sshiraki/ss_hand/女性の手型3Dプリント設計図.png

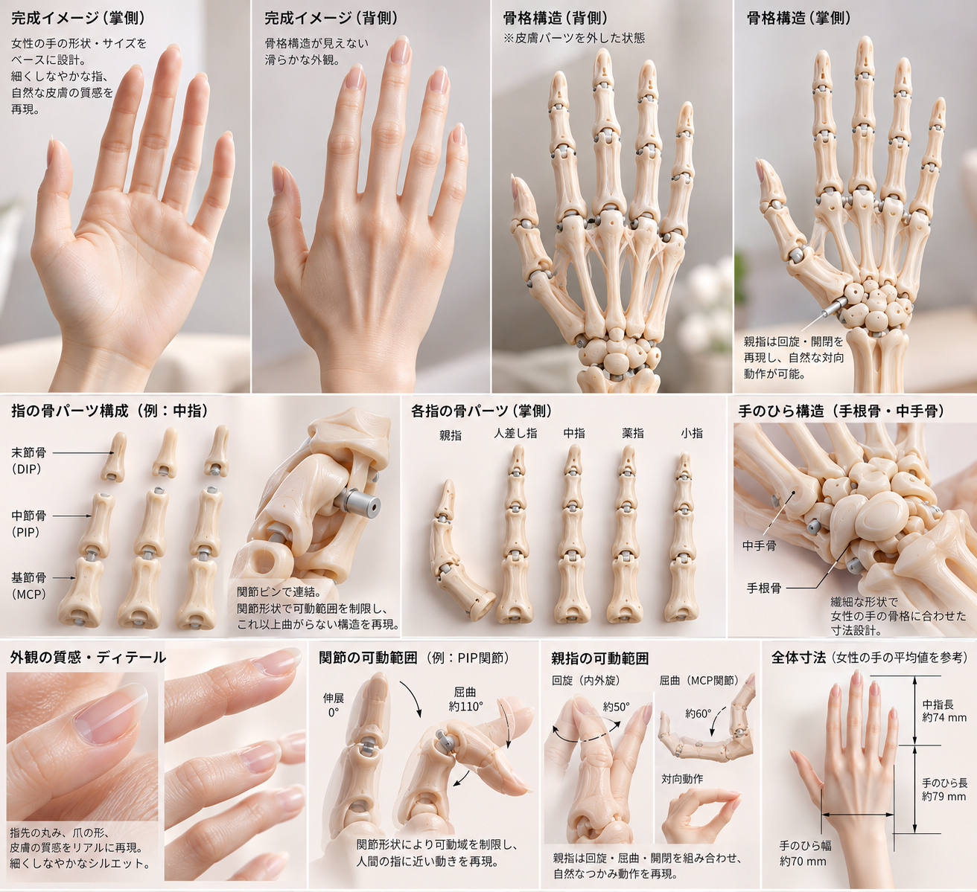
女性の手型3Dプリント設計図.png
