sshiraki/ss_hand/ball_joint_v11.png

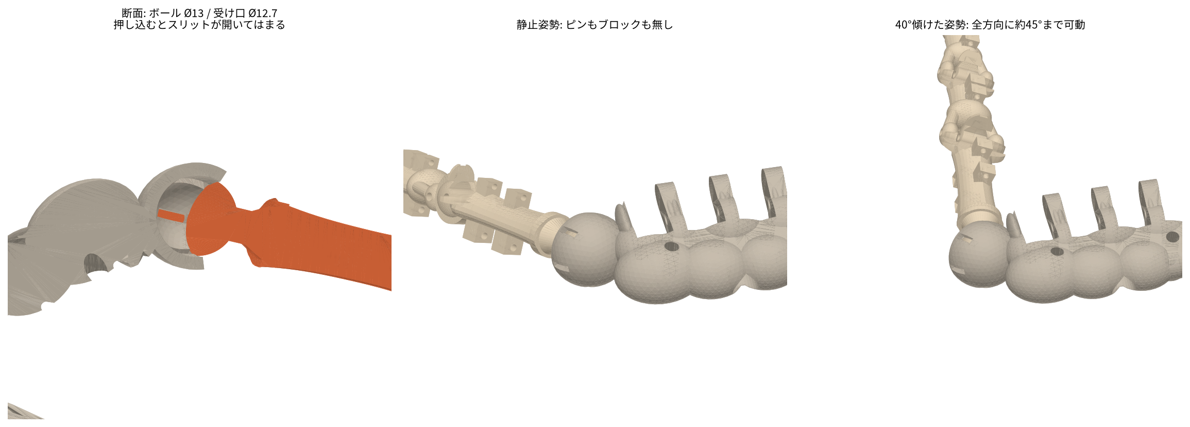
ball_joint_v11.png
