sshiraki/ss_hand/parts_list_v11.csv

part | vol_cm3 | size_x | size_y | size_z | watertight | components
carpus_wrist_base | 9.66 | 65.1 | 30.5 | 20.1 | True | 1
index_distal | 0.89 | 12.1 | 28.5 | 12.7 | True | 1
index_metacarpal | 3.08 | 14.7 | 73.2 | 14.0 | True | 1
index_middle | 1.19 | 13.3 | 34.8 | 13.7 | True | 1
index_proximal | 1.77 | 14.6 | 44.3 | 13.9 | True | 1
middle_distal | 1.0 | 12.7 | 30.0 | 13.1 | True | 1
middle_metacarpal | 3.47 | 15.3 | 75.6 | 14.5 | True | 1
middle_middle | 1.39 | 13.9 | 37.2 | 14.1 | True | 1
middle_proximal | 2.0 | 15.2 | 46.8 | 14.4 | True | 1
pinky_distal | 0.67 | 11.2 | 24.6 | 11.8 | True | 1
pinky_metacarpal | 2.3 | 12.8 | 64.3 | 13.2 | True | 1
pinky_middle | 0.81 | 11.9 | 28.8 | 12.9 | True | 1
pinky_proximal | 1.12 | 12.7 | 37.4 | 12.9 | True | 1
ring_distal | 0.89 | 12.1 | 28.5 | 12.7 | True | 1
ring_metacarpal | 2.99 | 14.7 | 71.2 | 14.0 | True | 1
ring_middle | 1.24 | 13.3 | 35.8 | 13.7 | True | 1
ring_proximal | 1.77 | 14.6 | 44.3 | 13.9 | True | 1
thumb_distal | 1.64 | 15.2 | 37.7 | 14.8 | True | 1
thumb_metacarpal | 4.04 | 17.2 | 61.5 | 16.8 | True | 1
thumb_proximal | 2.29 | 17.1 | 44.7 | 15.4 | True | 1
