sshiraki/ss_hand/3mf/assembly.3mf

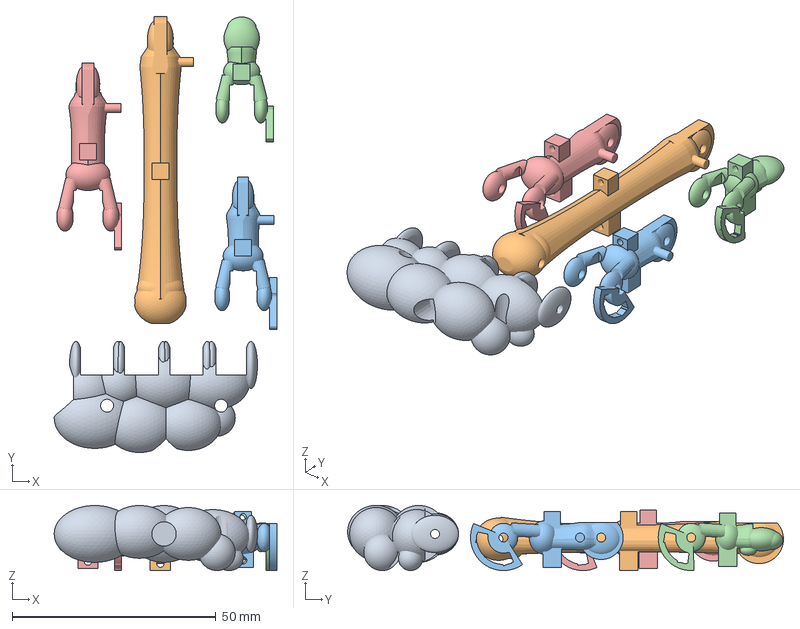
[picture p3: CAD file, 2026-11-10]
3mf/assembly.3mf
54.7 x 107.1 x 16.0 mm
carpus_wrist_base.stl
middle_metacarpal.stl
middle_middle.stl
middle_distal.stl
middle_proximal.stl
