sshiraki/ss_hand/3mf/middke.3mf

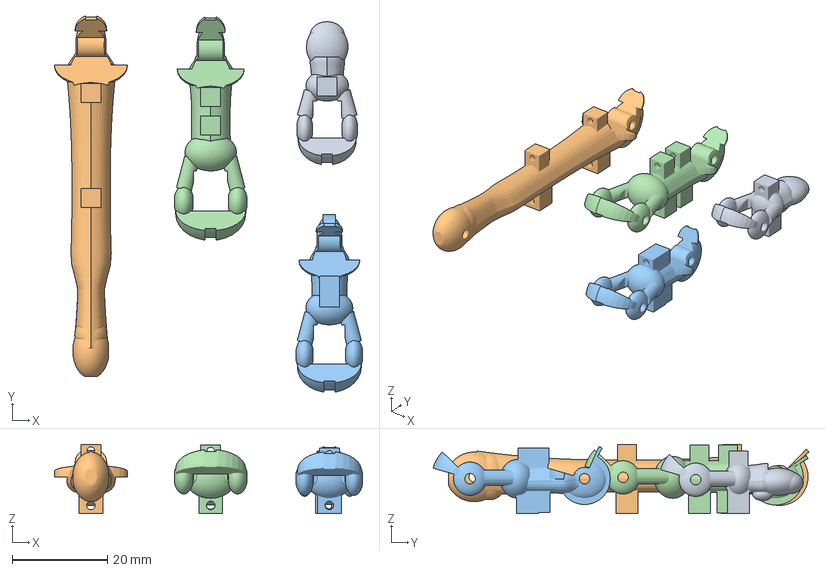
[picture p4: CAD file, 2026-11-10]
3mf/middke.3mf
64.6 x 78.8 x 14.5 mm
middle_distal.stl
middle_metacarpal.stl
middle_middle.stl
middle_proximal.stl
