sshiraki/ss_hand/stl/carpus_wrist_base.stl

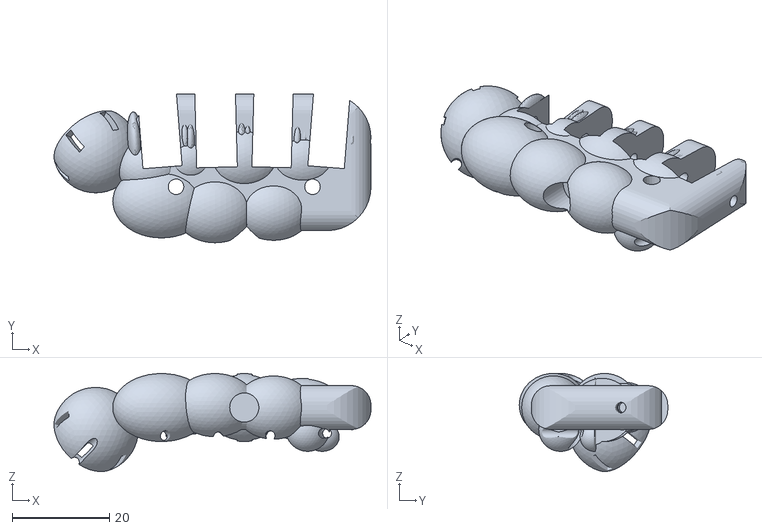
[picture p5: CAD file, 2026-11-10]
stl/carpus_wrist_base.stl
65.1 x 30.5 x 20.1
