sshiraki/ss_hand/3mf/thumb.3mf

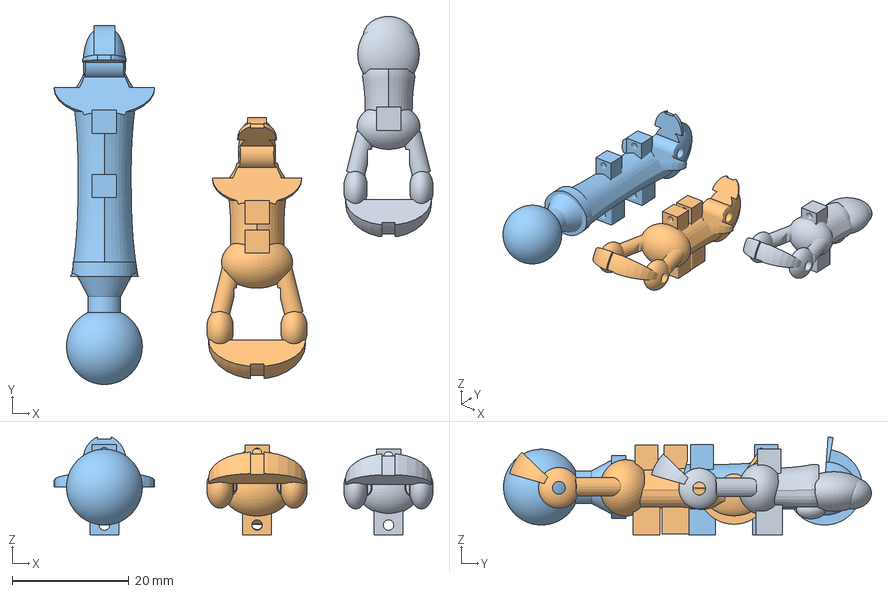
[picture p6: CAD file, 2026-11-10]
3mf/thumb.3mf
64.9 x 63.1 x 16.8 mm
thumb_distal.stl
thumb_proximal.stl
thumb_metacarpal.stl
