sshiraki/ss_hand/stl/thumb_metacarpal.stl

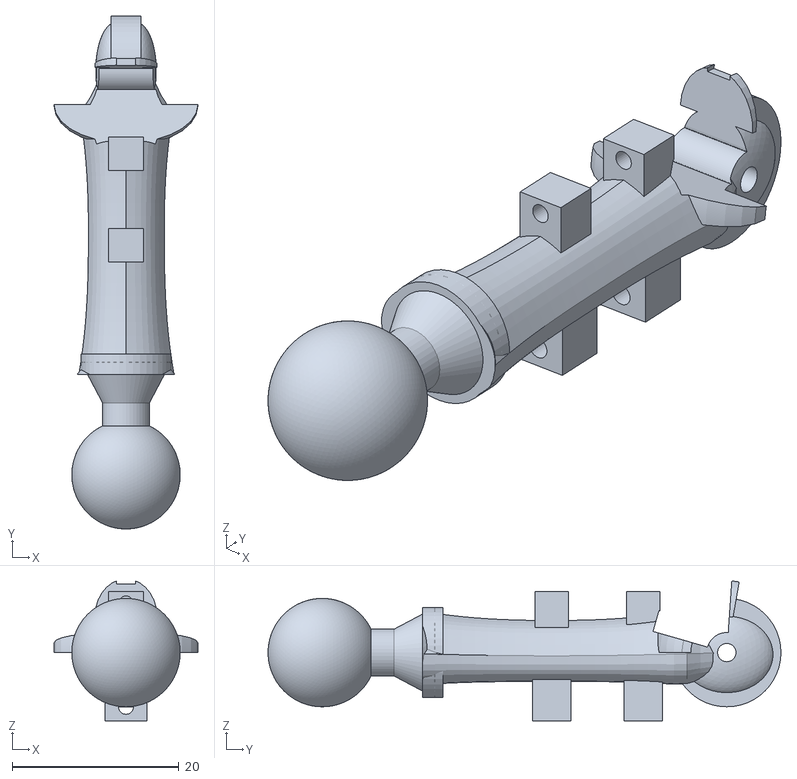
[picture p7: CAD file, 2026-11-10]
stl/thumb_metacarpal.stl
17.2 x 61.5 x 16.8
