sshiraki/ss_hand/3mf/index.3mf

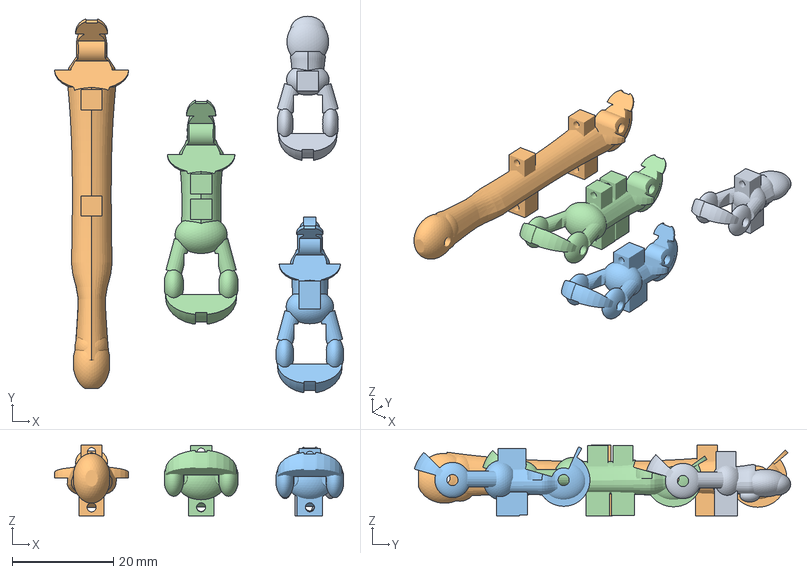
[picture p8: CAD file, 2026-11-10]
3mf/index.3mf
57.2 x 74.5 x 14.0 mm
index_distal.stl
index_metacarpal.stl
index_middle.stl
index_proximal.stl
