sshiraki/ss_hand/stl/thumb_distal.stl

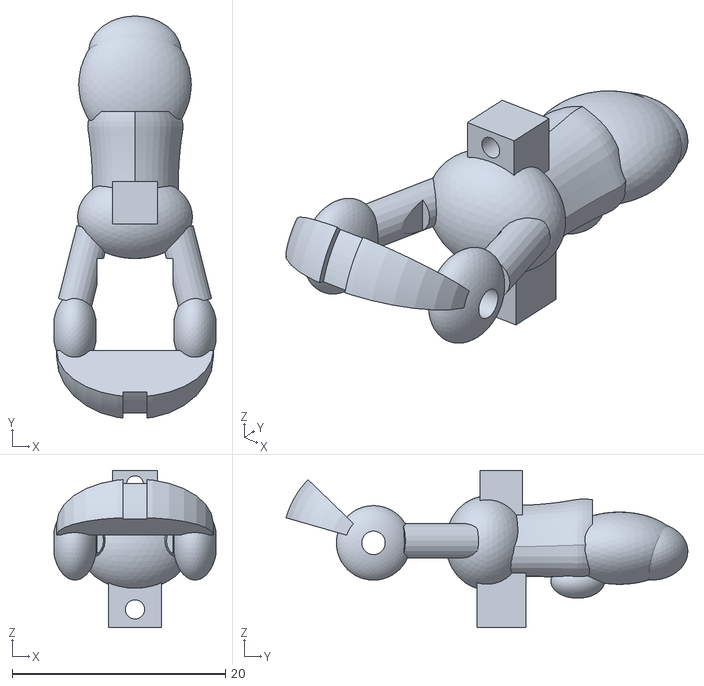
[picture p9: CAD file, 2026-11-10]
stl/thumb_distal.stl
15.2 x 37.7 x 14.8
