sshiraki/ss_hand/3mf/ring.3mf

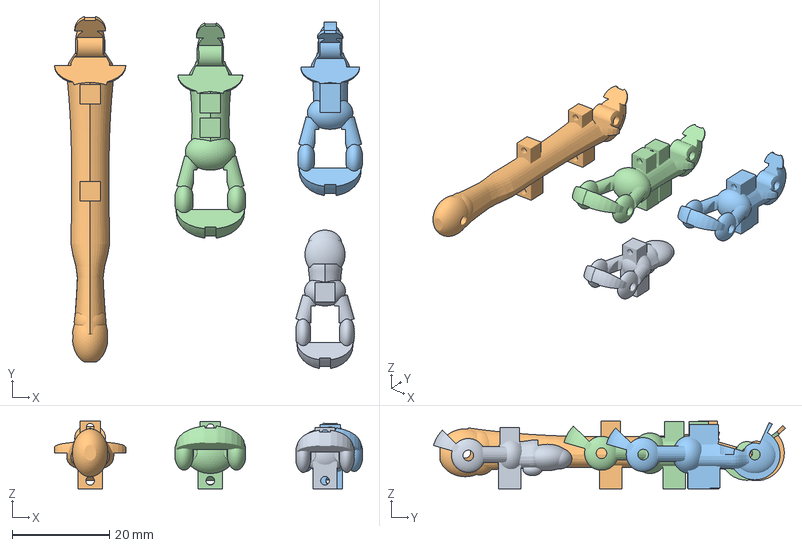
[picture p10: CAD file, 2026-11-10]
3mf/ring.3mf
63.4 x 72.5 x 14.0 mm
ring_distal.stl
ring_metacarpal.stl
ring_middle.stl
ring_proximal.stl
