sshiraki/ss_hand/stl/middle_distal.stl

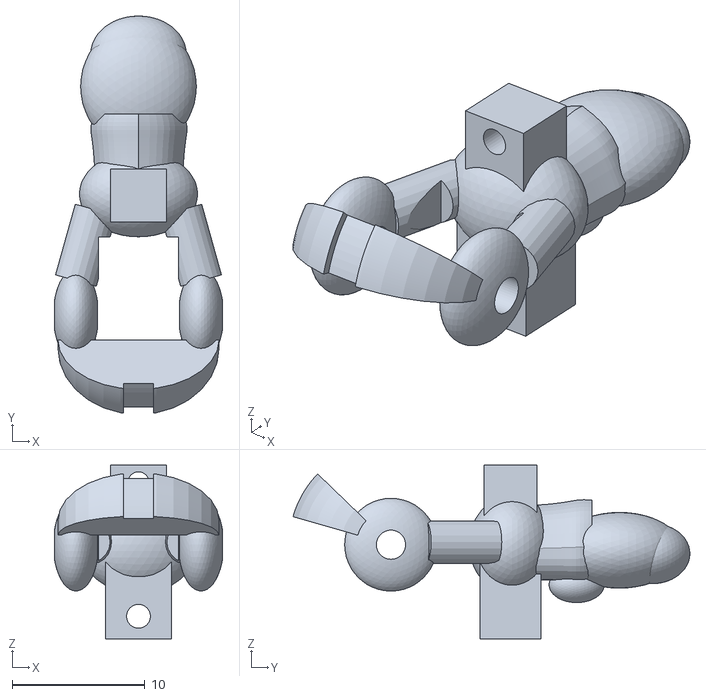
[picture p11: CAD file, 2026-11-10]
stl/middle_distal.stl
12.7 x 30.0 x 13.1
