sshiraki/ss_hand/3mf/pinky.3mf

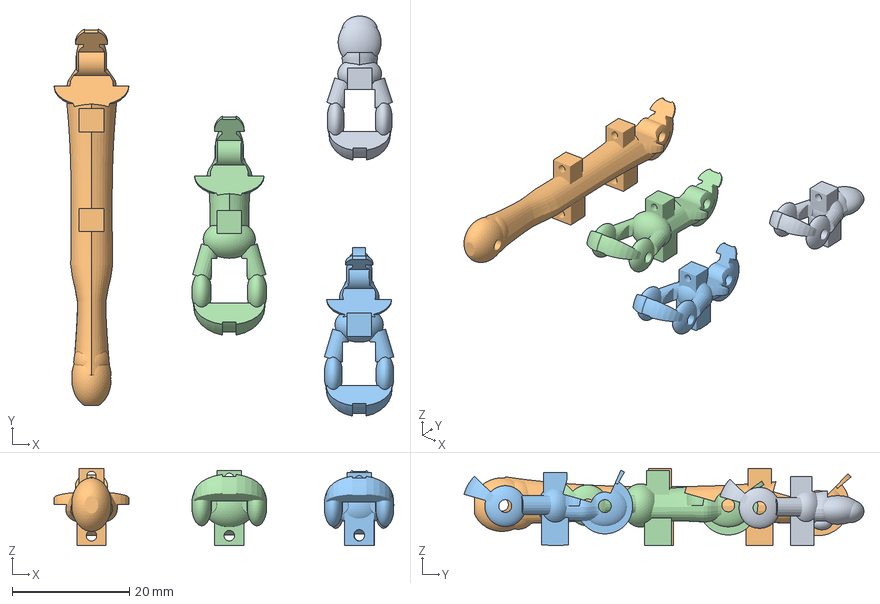
[picture p12: CAD file, 2026-11-10]
3mf/pinky.3mf
58.0 x 68.3 x 13.2 mm
pinky_distal.stl
pinky_metacarpal.stl
pinky_middle.stl
pinky_proximal.stl
