sshiraki/ss_hand/stl/pinky_distal.stl

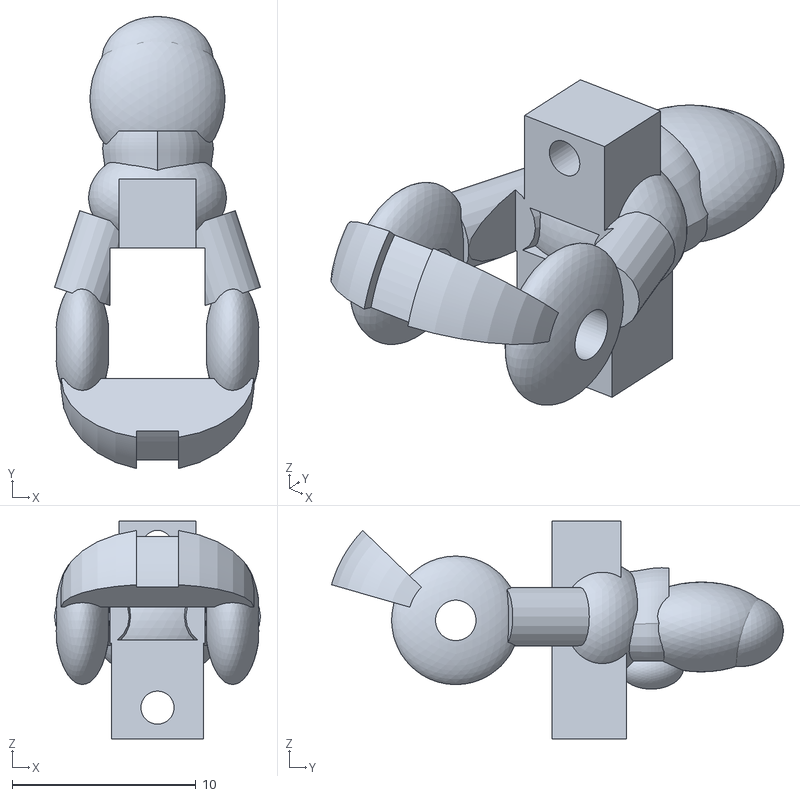
[picture p13: CAD file, 2026-11-10]
stl/pinky_distal.stl
11.2 x 24.6 x 11.8
