sshiraki/ss_hand/stl/pinky_middle.stl

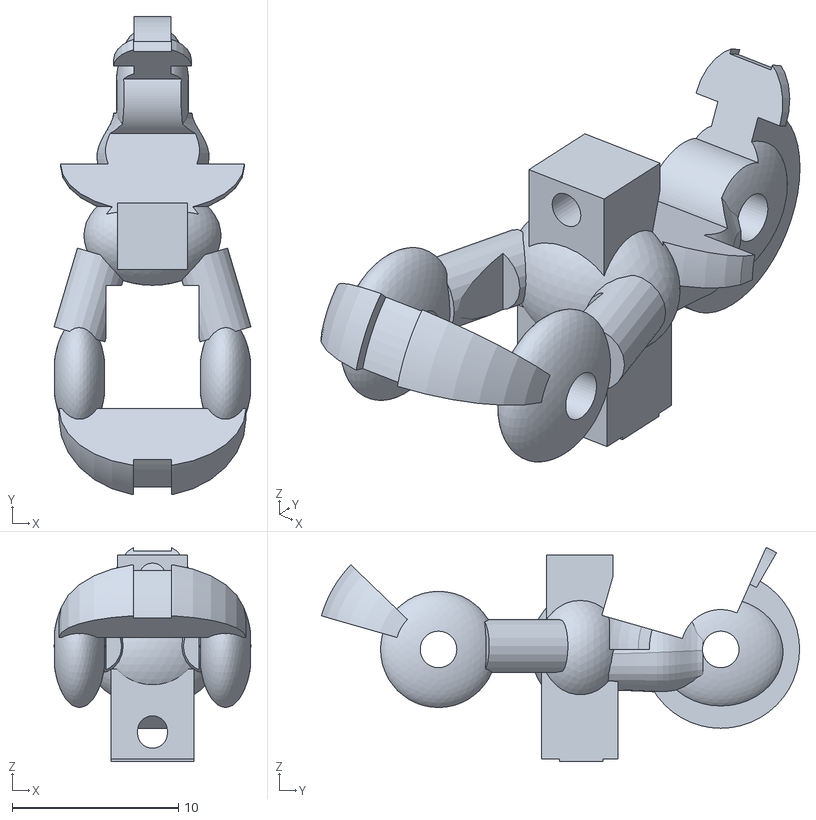
[picture p14: CAD file, 2026-11-10]
stl/pinky_middle.stl
11.9 x 28.8 x 12.9
