sshiraki/ss_hand/stl/pinky_metacarpal.stl

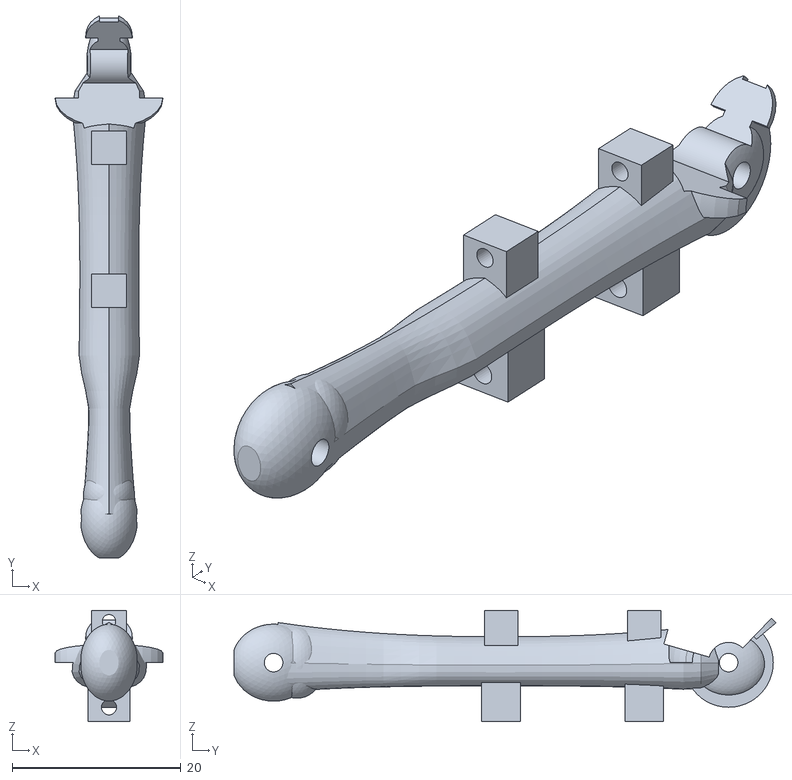
[picture p15: CAD file, 2026-11-10]
stl/pinky_metacarpal.stl
12.8 x 64.3 x 13.2
