sshiraki/ss_hand/stl/thumb_proximal.stl

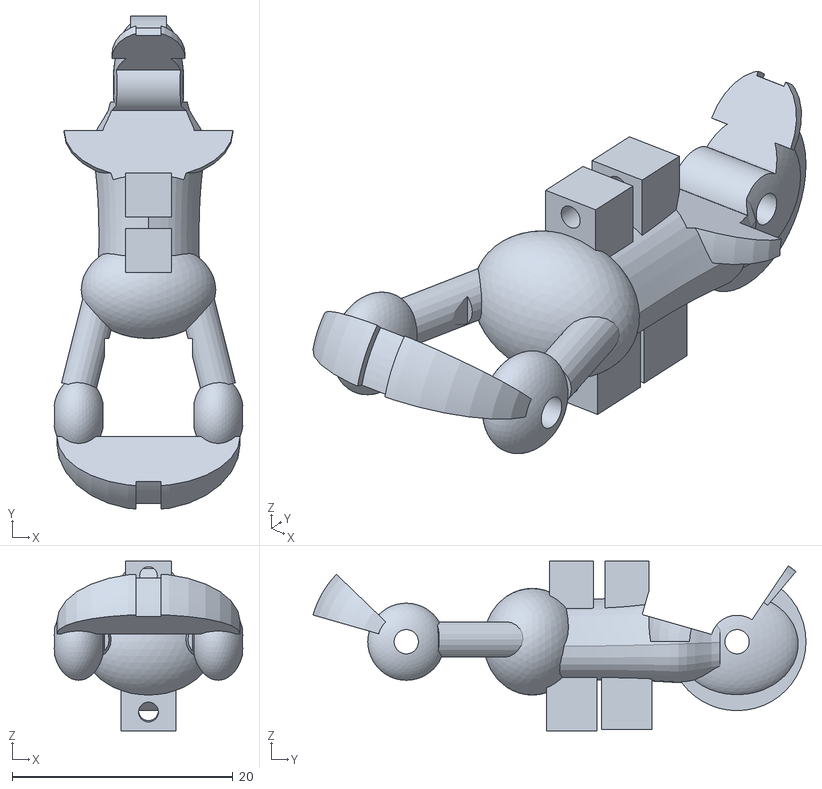
[picture p16: CAD file, 2026-11-10]
stl/thumb_proximal.stl
17.1 x 44.7 x 15.4
