sshiraki/ss_hand/stl/pinky_proximal.stl

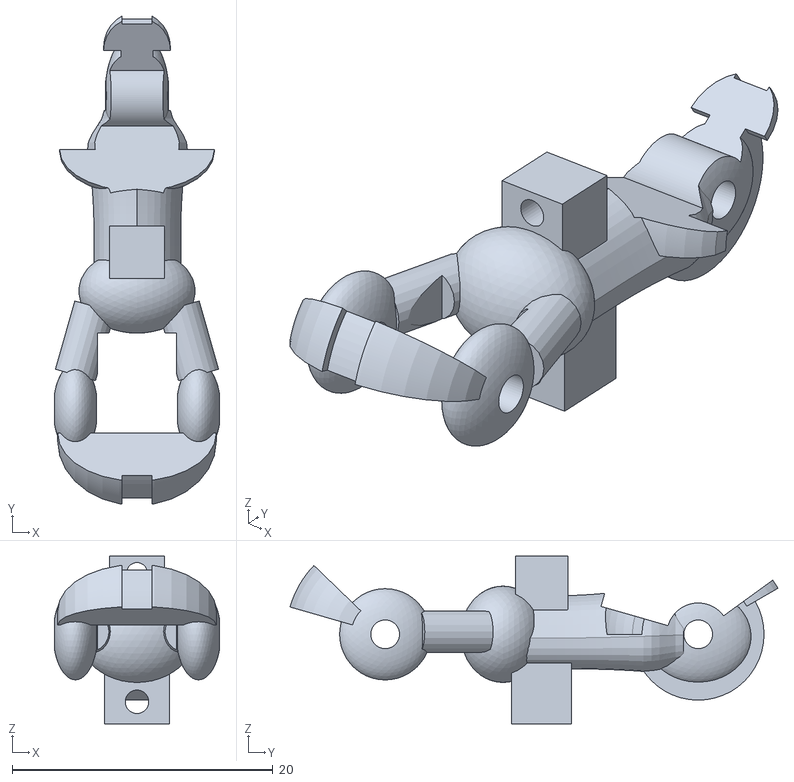
[picture p17: CAD file, 2026-11-10]
stl/pinky_proximal.stl
12.7 x 37.4 x 12.9
