sshiraki/ss_hand/stl/middle_metacarpal.stl

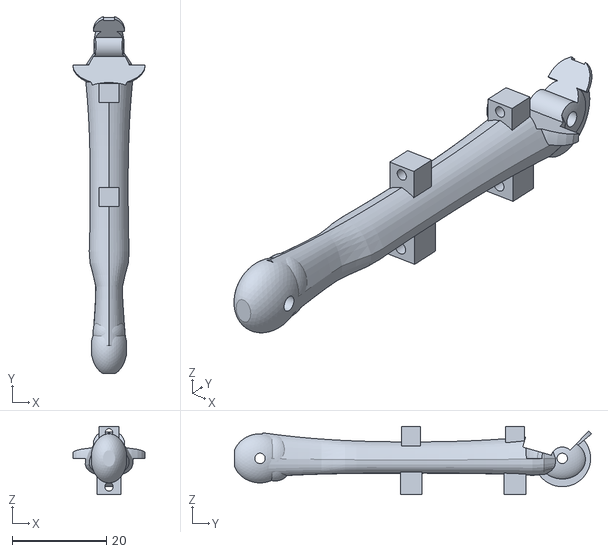
[picture p18: CAD file, 2026-11-10]
stl/middle_metacarpal.stl
15.3 x 75.6 x 14.5
