sshiraki/ss_hand/stl/middle_middle.stl

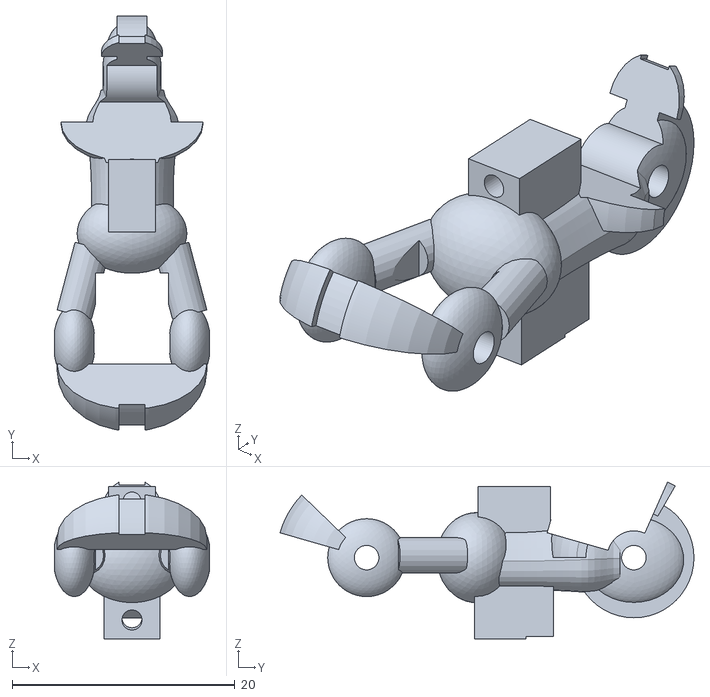
[picture p19: CAD file, 2026-11-10]
stl/middle_middle.stl
13.9 x 37.2 x 14.1
