sshiraki/ss_hand/stl/index_proximal.stl

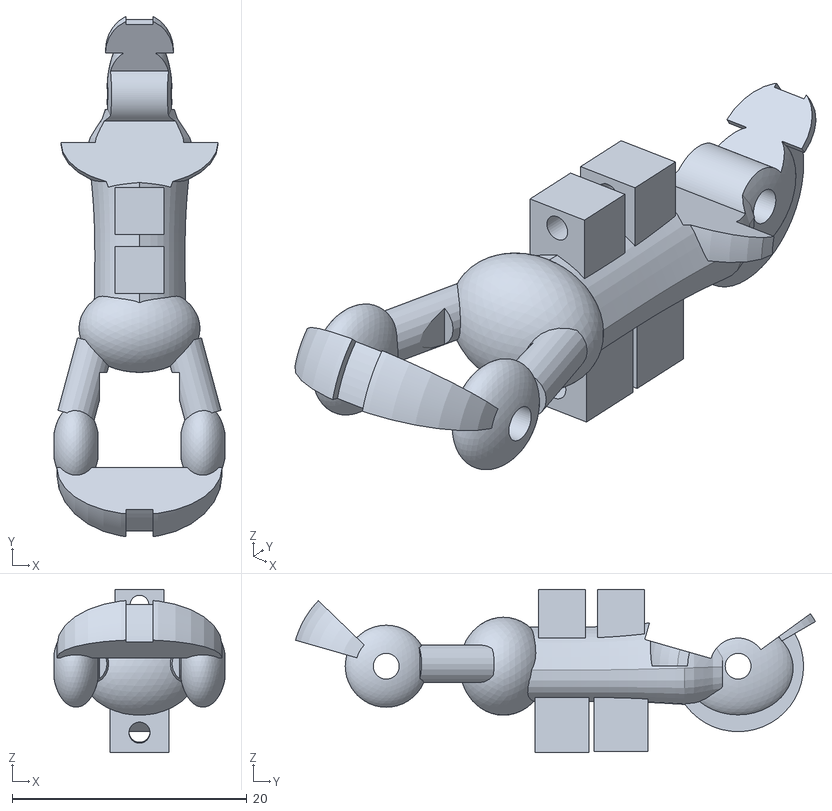
[picture p20: CAD file, 2026-11-10]
stl/index_proximal.stl
14.6 x 44.3 x 13.9
