sshiraki/ss_hand/stl/ring_middle.stl

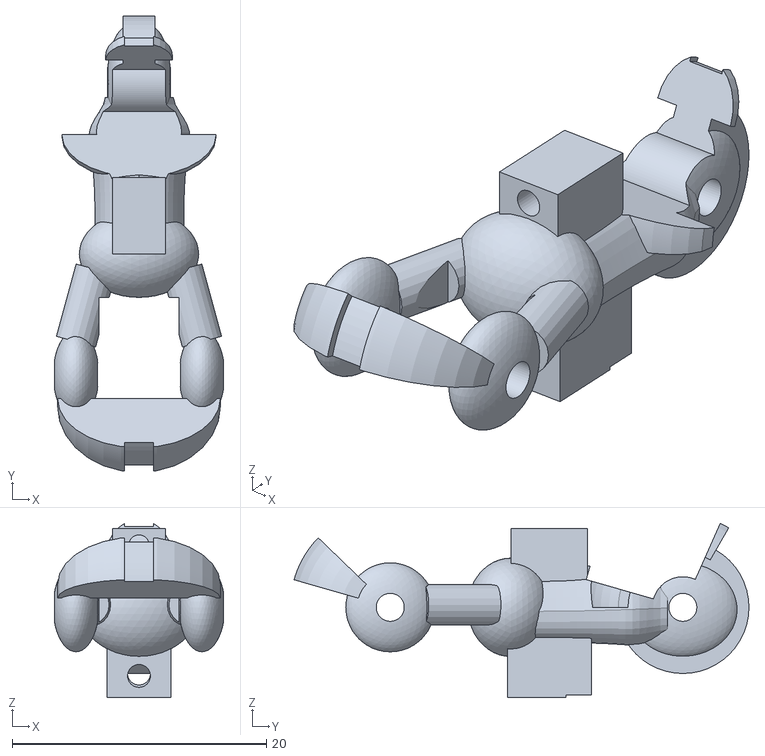
[picture p21: CAD file, 2026-11-10]
stl/ring_middle.stl
13.3 x 35.8 x 13.7
