sshiraki/ss_hand/stl/index_metacarpal.stl

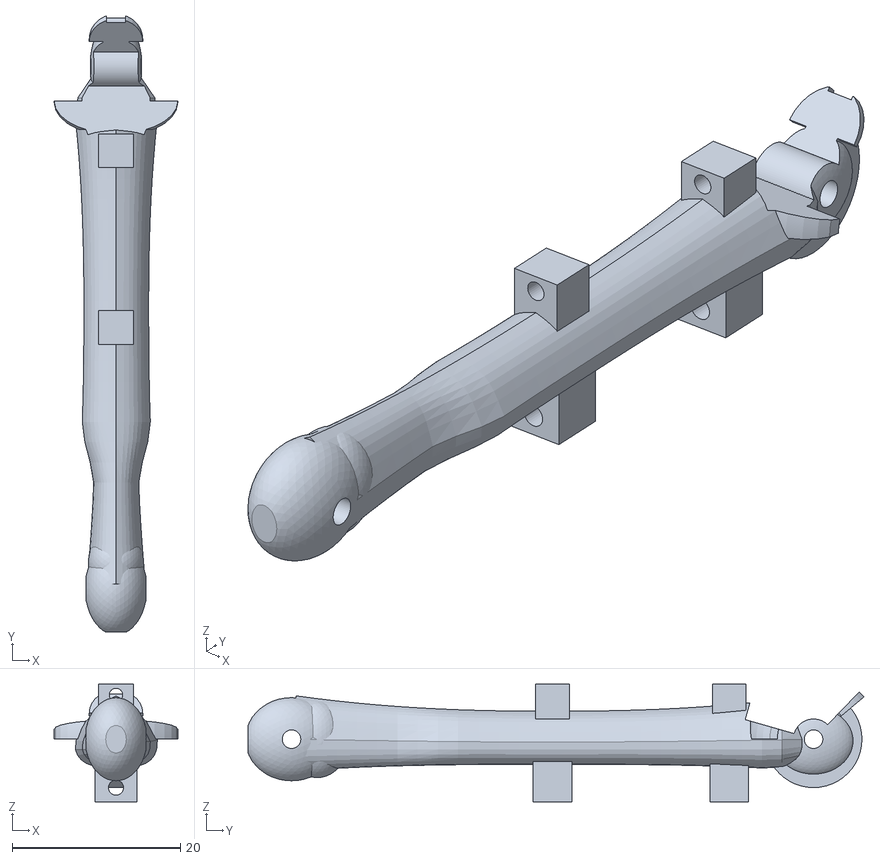
[picture p22: CAD file, 2026-11-10]
stl/index_metacarpal.stl
14.7 x 73.2 x 14.0
