sshiraki/ss_hand/stl/index_middle.stl

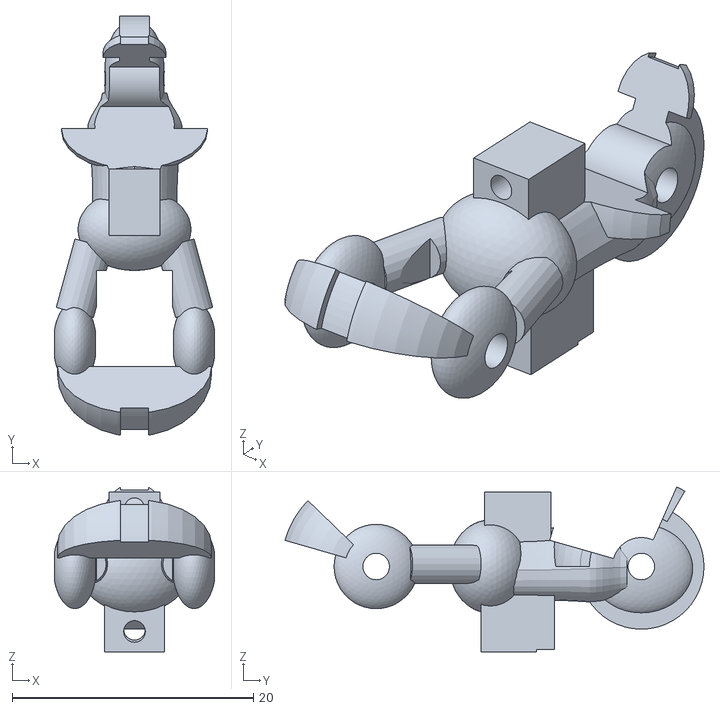
[picture p23: CAD file, 2026-11-10]
stl/index_middle.stl
13.3 x 34.8 x 13.7
