sshiraki/ss_hand/stl/middle_proximal.stl

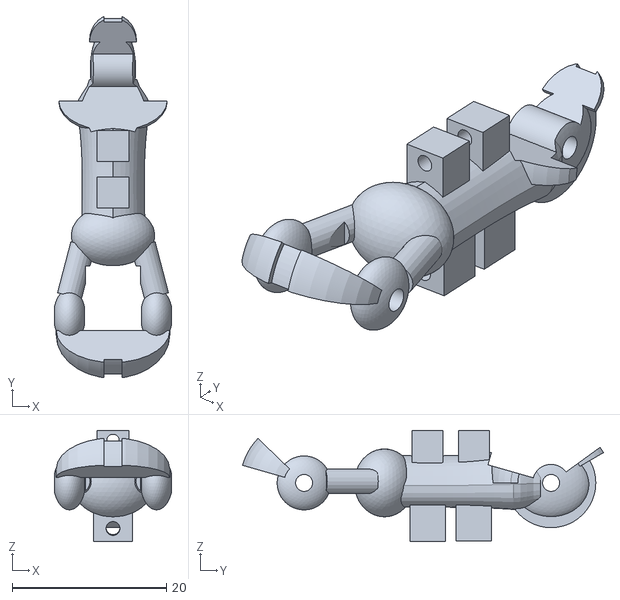
[picture p24: CAD file, 2026-11-10]
stl/middle_proximal.stl
15.2 x 46.8 x 14.4
