sshiraki/ss_hand/stl/ring_metacarpal.stl

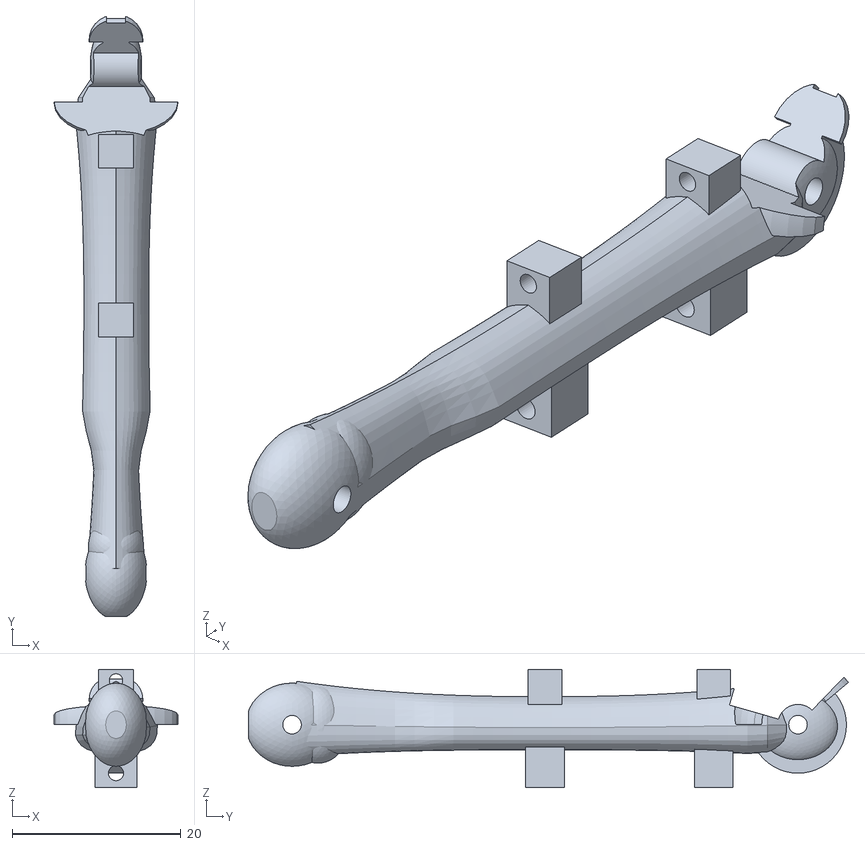
[picture p25: CAD file, 2026-11-10]
stl/ring_metacarpal.stl
14.7 x 71.2 x 14.0
