sshiraki/ss_hand/stl/ring_distal.stl

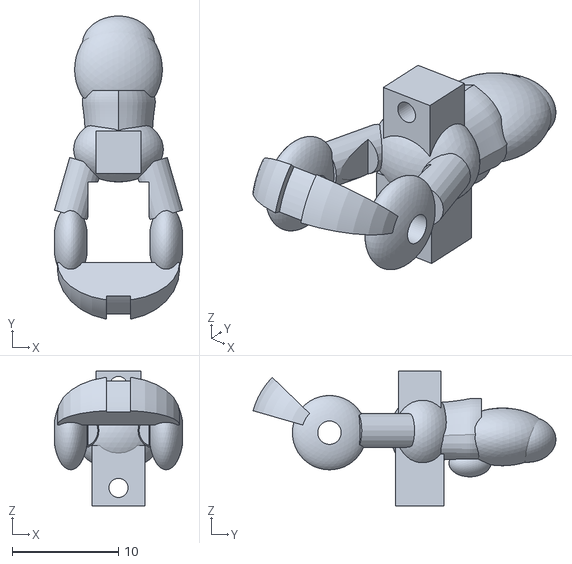
[picture p26: CAD file, 2026-11-10]
stl/ring_distal.stl
12.1 x 28.5 x 12.7
