sshiraki/ss_hand/(list of files, cad)

Other CAD files:
3mf/Base.3mf
